dervish77/RetroAV/README.md

# RetroAV
Retro AV shield for Arduino Uno 

The RetroAV shield provides the interfaces necessary to implement a simple retro style computer user interface using a PS2 keyboard for input, composite video and analog audio for output.  

It is assumed that the RetroAV shield will be used with an Arduino board (UNO boards will be supported by default, other variants may require code modifications).  The combination of the RetroAV shield and an Ardunio will essentially form a simple text terminal similar in spirit to a VT100 terminal of the past.  It is hoped that this pairing can be combined with other microcontroller boards to form larger retro computing systems.

Repo contents:

* docs/          - system design docs, block diagrams, etc
* examples/      - example code using the RetroAV shield
* hw/            - hardware design files
* ref/           - reference documents for integrated packages
* src/           - source code for the RetroAV shield library
* tests/         - test programs for verifying shield hardware

## Requirements

* RetroAV shield **shall** support PS2 keyboard input using standard PS2 connector.

* RetroAV shield **shall** support composite video output using single RCA output jack.  
  * RetroAV **shall** support black & white video output.
  * RetroAV **shall** support at least 20 characters by 16 lines of video output. 
  * RetroAV *should* support at least 40 characters by 24 lines of video output.
  * RetroAV *should* support color output if possible.

* RetroAV shield **shall** support analog audio output using RCA output jack.
  * RetroAV **shall** support a 1 volt peak to peak output signal.
  * RetroAV **shall** support at least one "voice" of audio output.
  * RetroAV *should* support more than one "voice" of audio output if possible.

* RetroAV shield **shall** support a serial interface connector.
  * RetroAV **shall** support a UART style serial interface.
    * RetroAV **shall** support a UART interface via a 4 pin header.
    * RetroAV *should* support a UART interface via a DB9 connector.

* RetroAV code library **shall** minimally support a simple text terminal style of interface.
  * RetroAV **shall** support the standard ascii character set.
  * RetroAV **shall** support playing an audio tone for the bell character (i.e. control-G).
  * RetroAV **shall** support interfacing via the Arduino serial monitor (i.e. echo characters to serial monitor).
  * RetroAV *should* support interfacing via Arduino serial data pins (i.e. uart pins).

* RetroAV code library **shall** minimally support a standard Arduino UNO board.
  * RetroAV *should* be supportable on variant boards via simple code modifications.

## High Level Design

### System Block Diagram

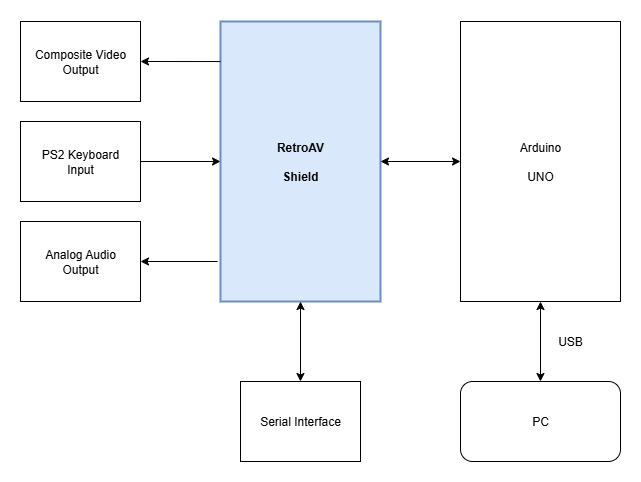
[picture p1: docs/RetroAV-System-Block-Diagram.png]
system


### HW Block Diagram

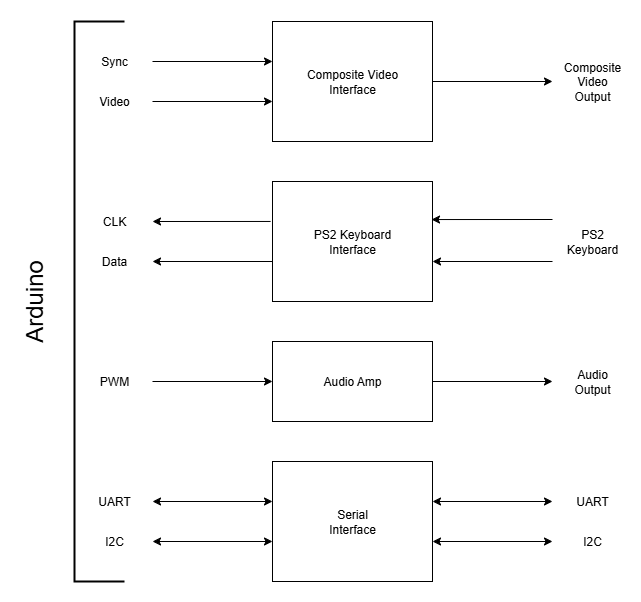
[picture p2: docs/RetroAV-HW-Block-Diagram.png]
HW


### SW Block Diagram

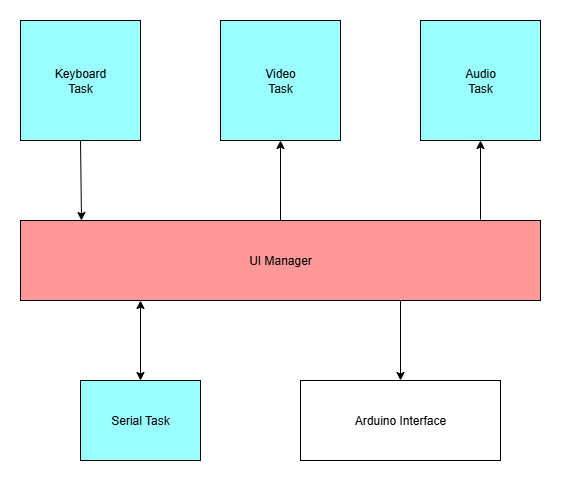
[picture p3: docs/RetroAV-SW-Block-Diagram.png]
SW


## Detailed Design

### Hardware

#### PS2 Keyboard Input

The PS2 keyboard input is a standard 6-pin PS2 keyboard connector.  This connector provides 5V power and ground to the PS2 keyboard and accepts the clock and data signals from the keyboard.  Clock is connected to PIO pin 3 on an Arduino UNO (note this signal must be connected to an IRQ input or the keyboard interface library won't work).  Data is connected to PIO pin 4 on an Arduino UNO.  

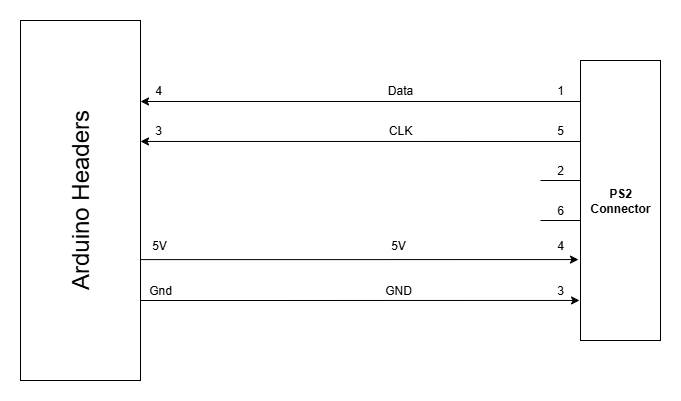
[picture p4: docs/RetroAV-PS2-HW-Diagram.png]
PS2


#### Composite Video Output

The Composite video output is a standard RCA connector.  This connector outputs the video signal and ground.  The output circuit takes in sync and video signals from the Arduino via series resistors.  This scheme is directly leveraging the TVout library method of creating composite video.  The sync signal uses pin 9 from an Arduino UNO.  The video signal uses pin 7 from an Arduino UNO.

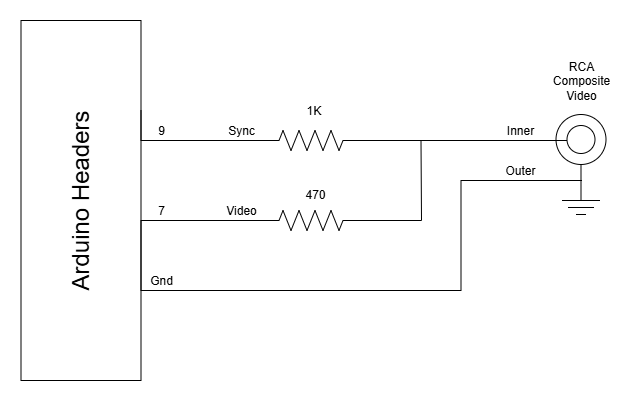
[picture p5: docs/RetroAV-Video-HW-Diagram.png]
Video


#### Audio Output

The Audio output is a standard RCA connector.  This connector outputs the mono audio signal and ground.  The output circuit takes in PWM audio from the Arduino via an RC circuit.  The PWM signal uses pin 11 from an Arduino UNO.

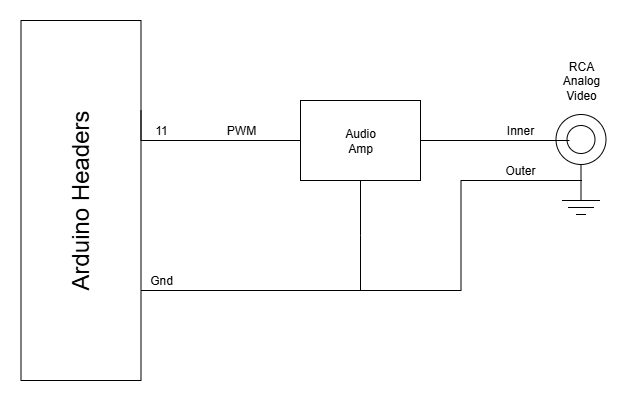
[picture p6: docs/RetroAV-Audio-HW-Diagram.png]
Audio


#### Serial Interface

The Serial Interface uses both a 4 pin header and a standard DB9 connector.  The 4 pin header connector outputs at TTL levels.  The DB9 connector outputs at compatible RS232 signal levels.

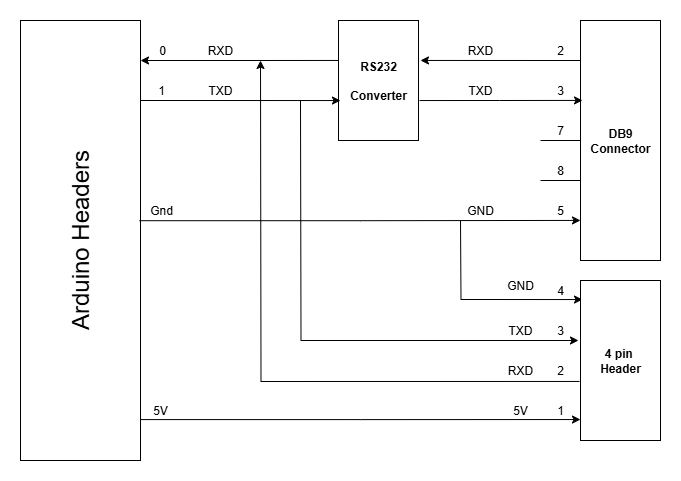
[picture p7: docs/RetroAV-Serial-HW-Diagram.png]


### Schematic

#### Shield Schematic

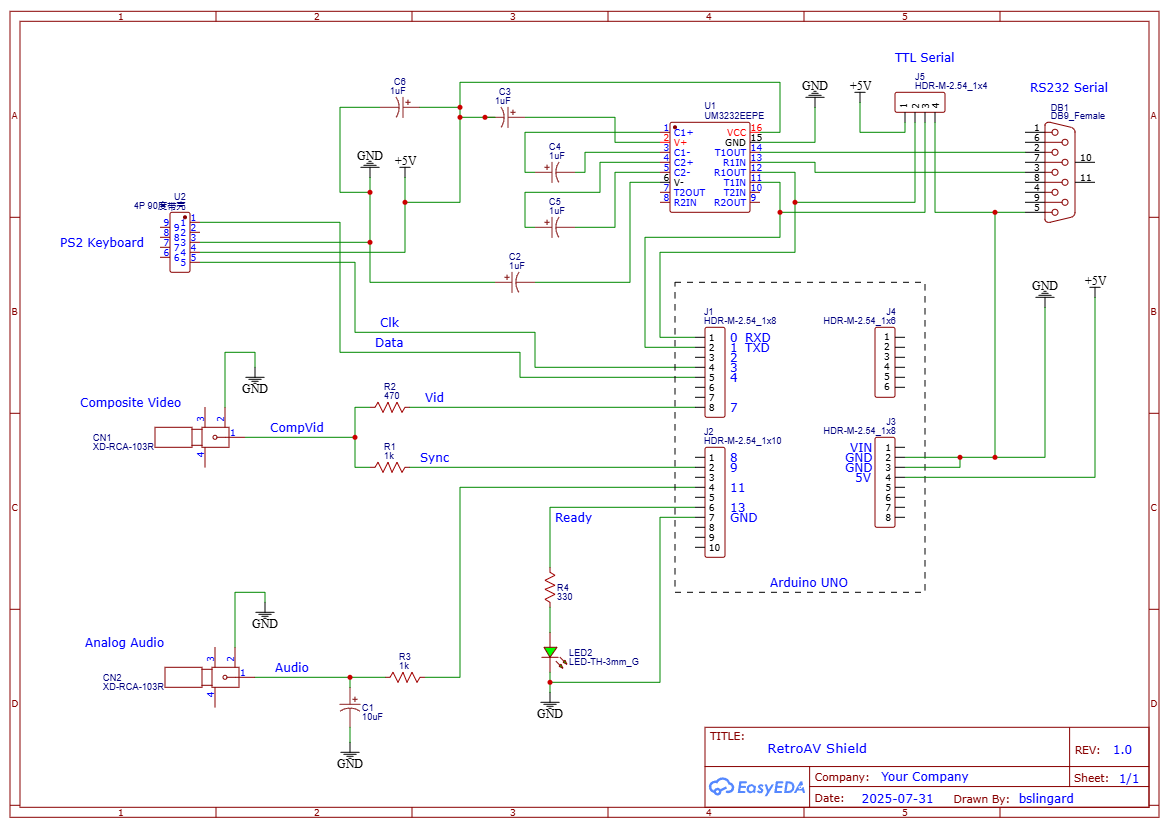
[picture p8: hw/Schematic_RetroAV.png]
Schematic


Schematic as a [PDF file](https://github.com/dervish77/RetroAV/blob/master/hw/Schematic_RetroAV.pdf)

### Software

#### UI Manager

The UI Manager coordinates the activities of all of the various tasks which make up the RetroAV system.

#### Arduino Interface

The Arduino Interface provides an interface to the underlying standard Arduino software layers.

#### Keyboard Task

The Keyboard Task receives character input from a PS2 keyboard and echoes those characters to the video output and to the serial interface.  The Keyboard Task leverages the [PS2KeyAdvanced Arduino libary](https://github.com/techpaul/PS2KeyAdvanced) to receive characters from keys typed on a PS2 keyboard.

#### Video Task

The Video Task manages the display of characters and graphics to the composite video output.  The Video Task leverages the [TVout Arduino library](https://github.com/Avamander/arduino-tvout) to generate composite video from two digital outputs, one for sync and on for video.

#### Audio Task

The Audio Task manages the output of analog audio via an RCA connector.  The Audio Task leverages the [Tone Arduino library](https://github.com/bhagman/Tone) to generate PWM based audio from a single output pin.

#### Serial Task

The Serial Task manages the input and output of characters to a host computer or other serial capable device.  The Serial Task leverages the [Poll-Serial Arduino library](https://github.com/ercanersoy/Poll-Serial) to utilize the TxD and RxD pins on the Arduino to perform RS232 communication through a level converter.

### Tests

#### Audio Test

The Audio Test verifies that the analog audio output is working correctly.

#### Keyboard Test

The Keyboard Test verifies that the PS2 keyboard interface is working correctly.

#### Serial Test

The Serial Test verifies that the RS232 serial interface is working correctly.

#### Video Test

The Video Test verifies that the composite video output is working correctly.
