dervish77/RetroAV/hw/readme.txt

RetroAV hw
==========

Notes:

- home for relevant hardware design information such as schematics for the RetroAV shield
