dervish77/RetroAV/docs/RetroAV-HW-Block-Diagram.pdf

Composite Video
Interface

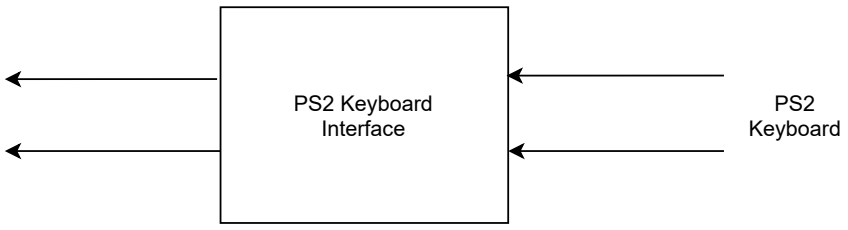
[picture p9: figure]
PS2 Keyboard Interface; PS2 Keyboard

Audio Amp

# Arduino

PWM

Sync Video

CLK

Data

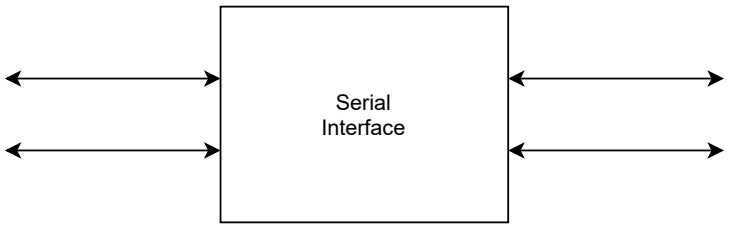
[picture p10: figure]
Serial Interface

UAR

T

I2C

Composite Video

Output

Audio
Output

UAR

T

I2C
