dervish77/RetroAV/docs/RetroAV-SW-Block-Diagram.pdf

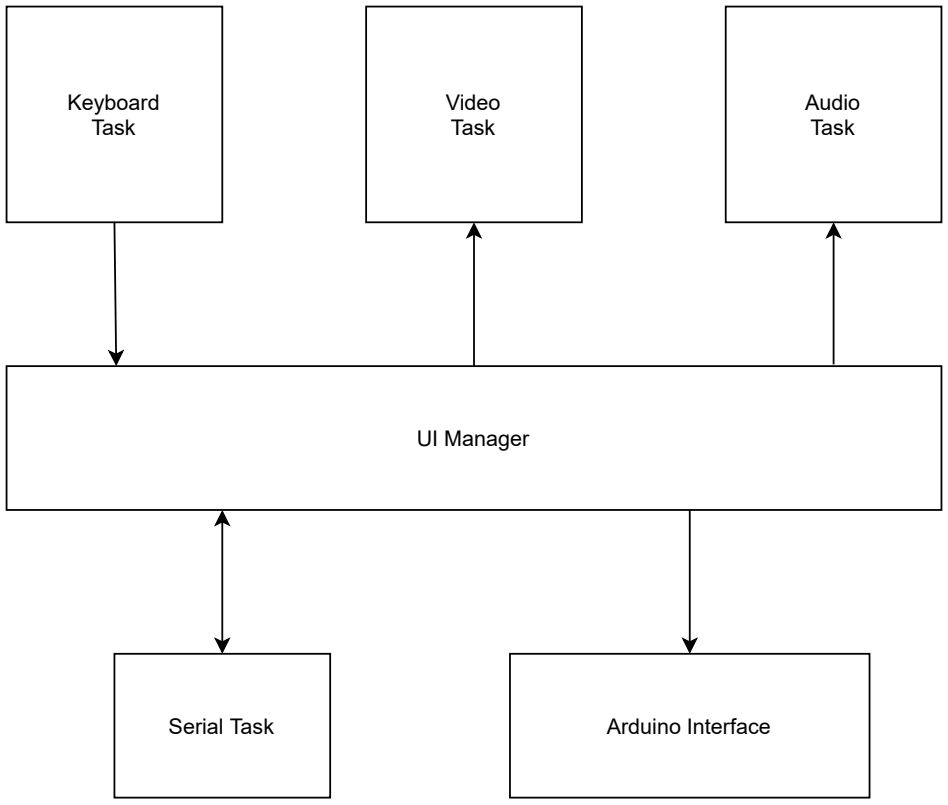
[picture p11: figure]
UI Manager; Keyboard Task; Audio Task; Video Task; Serial Task; Arduino Interface
