dervish77/RetroAV/docs/RetroAV-System-Block-Diagram.pdf

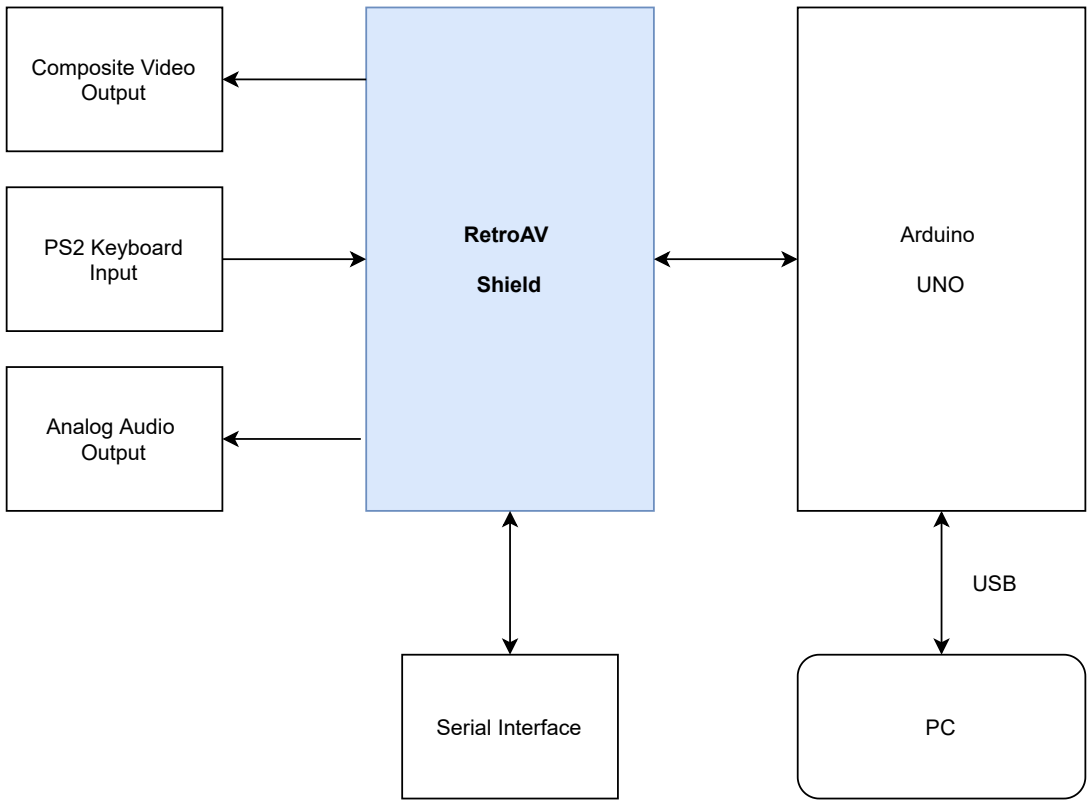
[picture p12: figure]
Arduino; UNO; RetroAV; Shield; Composite Video Output; PS2 Keyboard Input; Analog Audio Output; USB; Serial Interface
