dervish77/RetroAV/ref/max232-hookup.jpg

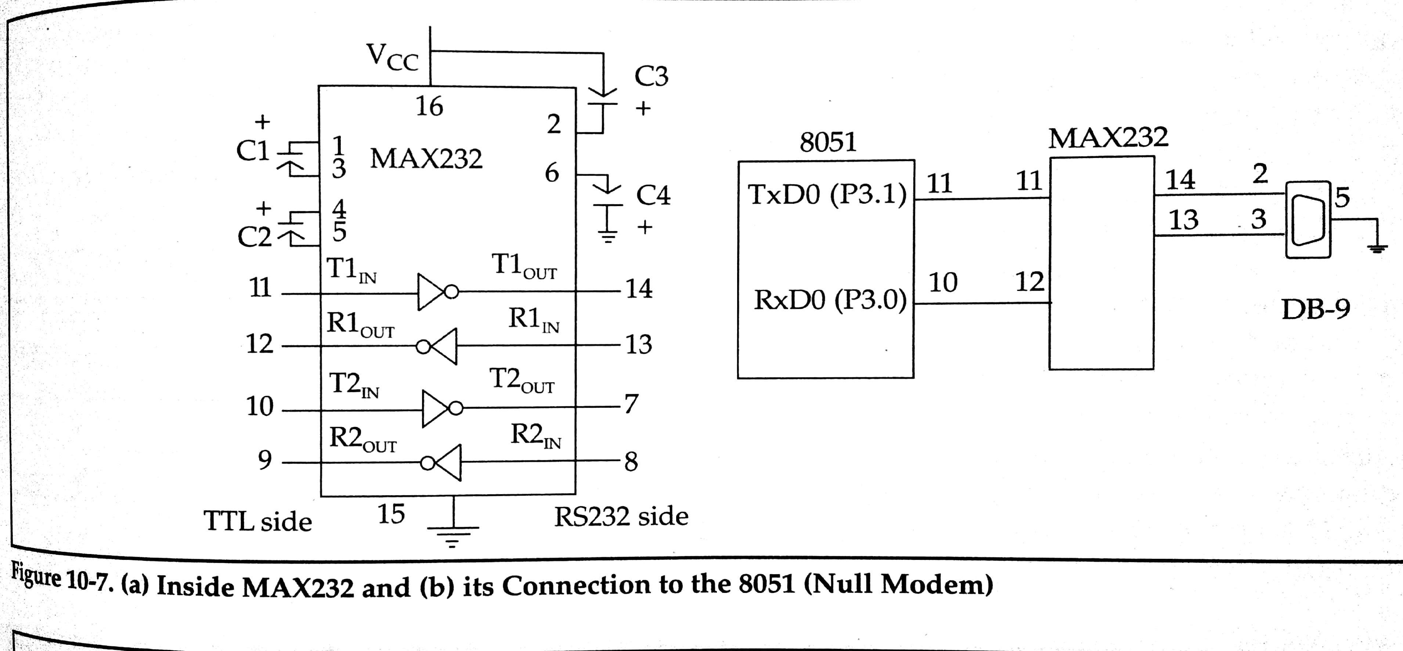
ref/max232-hookup.jpg
