dervish77/RetroAV/ref/serial-pinout-db9.jpg

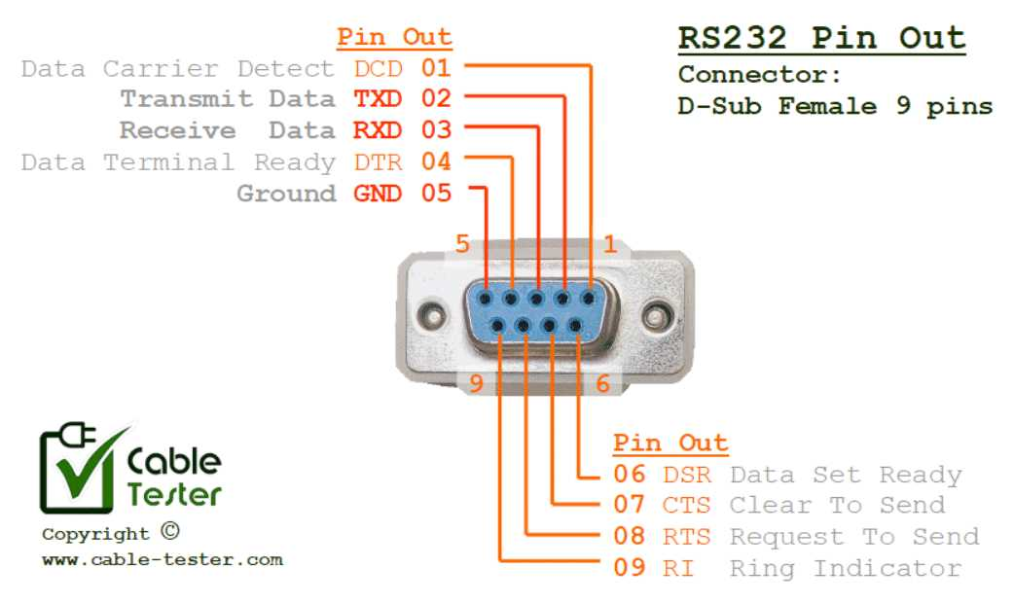
ref/serial-pinout-db9.jpg
