dervish77/RetroAV/tests/readme.txt

RetroAV tests
=============

Contains test programs as sketches for each functional area of the RetroAV shield:

audiotest/	- test of audio output interface

keytest/	- test of PS2 keyboard input interface

sertest/	- test of serial i/o interface

vidtest/	- test of composite video output interface
