dervish77/RetroAV/CHANGES.txt

CHANGES - RetroAV
=================

09/13/2025
- added top level makefile infrastructure
- added top level 'make release' target
- added build notes, release notes, fixed errors in makefiles
- added templates for audio test and serial test
- added 'make ide' targets
- bumped version to 0.1.1

08/11/2025
- added code for vidtest
- added code for keytest

08/06/2025
- modified shield code to perform serial check if no keyboard input
- added makefile to drive build/compile via arduino-cli tool
- added shield schematic EasyEDA project file
- moved schematic files from "docs" to "hw"
- added tests section to readme

07/31/2025
- added hookup diagram for MAX232 device
- added initial RetroAV shield source code
- added initial schematic for RetroAV shield

07/28/2025
- added serial interface diagrams
- added reference docs for serial hookup, DB9 connectors, RS232
- removed I2C requirement from serial interface

07/23/2025
- added interface diagrams for video, audio, keyboard
- added reference docs for PS2, TVout
- added MIT license

06/11/2021
- updated requirements to add serial interface
- updated block diagrams to add serial interface
- worked on detailed design for PS2 interface
- ordered PS2 connectors

06/04/2021
- documented requirements on README.md
- documented high level design
- completed block diagrams for system, hardware, and software

06/02/2021
- originated
