dervish77/RetroAV/hw/Schematic_RetroAV.pdf

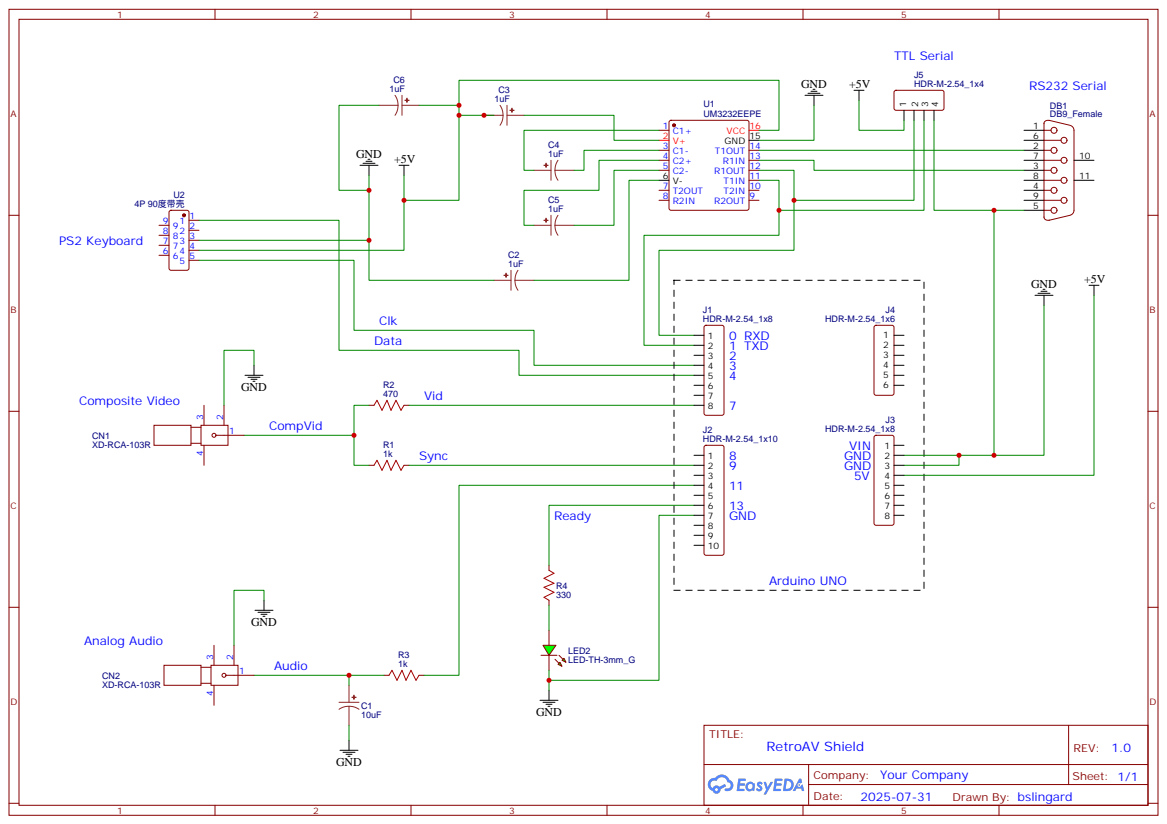
[picture p17: page 1]
