dervish77/RetroAV/(list of files, drawings)

Other design files:
hw/Schematic_RetroAV.json
