dervish77/RetroAV/tests/audiotest/AudioTest/AudioTest.ino

// AudioTest - test of RetroAV audio interface
//
// Target: Arduino UNO
//

#include <Arduino.h>
#include <stdint.h>
#include <stdlib.h>

//#include <PS2KeyAdvanced.h>

#include "Shield.h"


// define global variables
//PS2KeyAdvanced keyboard;


// define static variables


// Init the audio interface
void setup() {

}

// Run the audio interface tests
void loop() {


}
