dervish77/RetroAV/(commit log)

2025-07-23 renamed ps2 doc ; added pwm doc
2025-07-23 added ps2 schematic
2025-07-23 Update README.md
    updated ps2 section, added schematic ; wrote video and audio sections
2025-07-23 added video and audio schematics
2025-07-23 Update README.md
    added audio and video schematics
2025-07-28 Update README.md
    removed i2c serial requirement ; fleshed out sw descriptions
2025-07-28 modified audio diagram to include amp instead of filter
2025-07-29 modified serial diagram to include 4 pin header
2025-07-30 fixed to using correct serial pins
    [RetroUI.h]
2025-07-31 added schematics for retroav shield
2025-07-31 fixed schematic error, had wrong gender for headers
2025-07-31 Update README.md
    added schematic
2025-07-31 Update README.md
    fixed typo in schematic file name
2025-08-03 added 4 pin header schematic
2025-08-03 renamed pdf of schematic
2025-08-06 added shield schematic EasyEDA project file
    [Schematic_RetroAV.json]
2025-08-06 added makefile to drive build/compile via arduino-cli tool
2025-08-06 moved schematics from docs to hw folder
    [Schematic_RetroAV.json]
2025-08-06 Update README.md
    reflect movement of schematics from docs to hw folder
